raitzjm/SkidSteer_PCB/SkidSteer_PCB.jpg

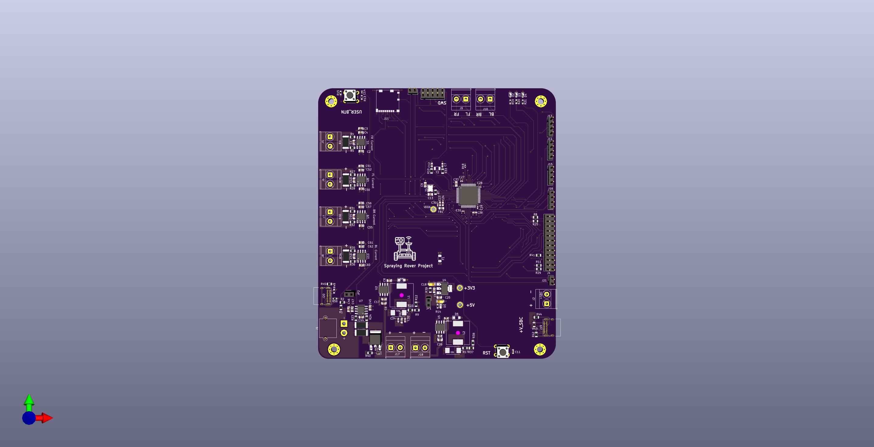
SkidSteer_PCB.jpg
