raitzjm/SkidSteer_PCB/README.md

# SkidSteer_PCB
PCB for skid steer spraying rover project for KSU Precision Ag Lab
