raitzjm/SkidSteer_PCB/Documentation/Capture.PNG

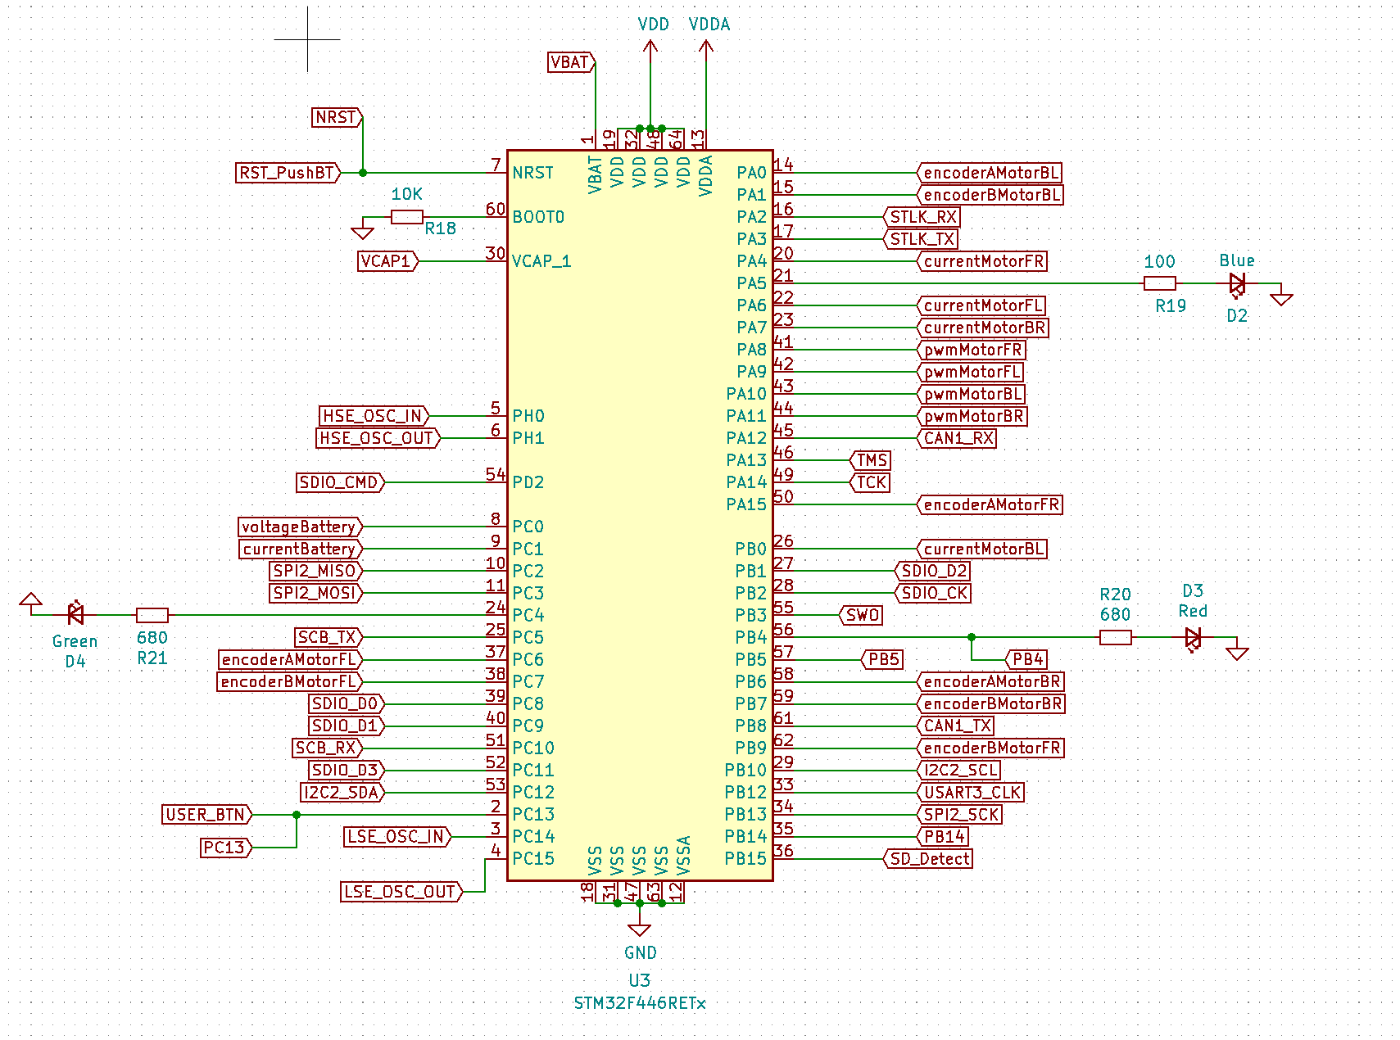
Documentation/Capture.PNG
