raitzjm/SkidSteer_PCB/SkidSteer_PCB.kicad_pcb

## KiCad design SkidSteer_PCB.kicad_pcb (2021-12-23)

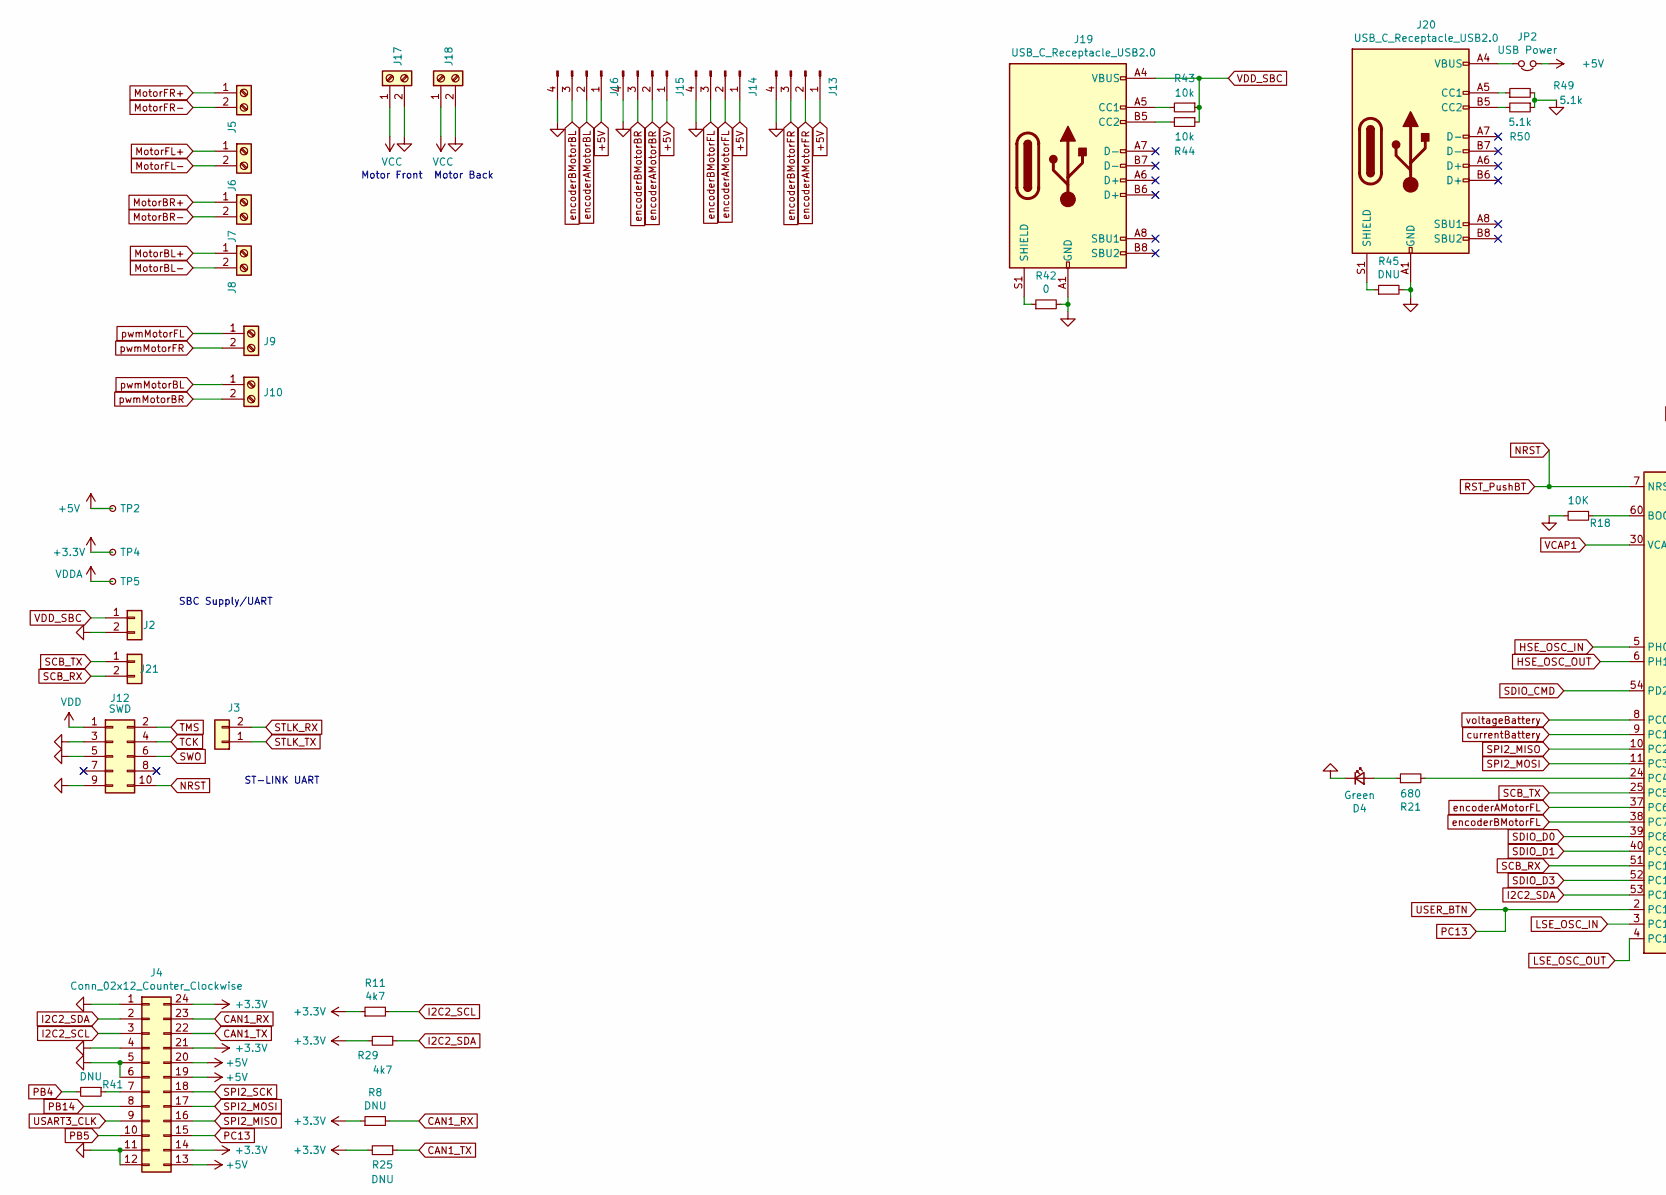
[picture p5: schematic SkidSteer_PCB.sch, part in row 1, column 1]

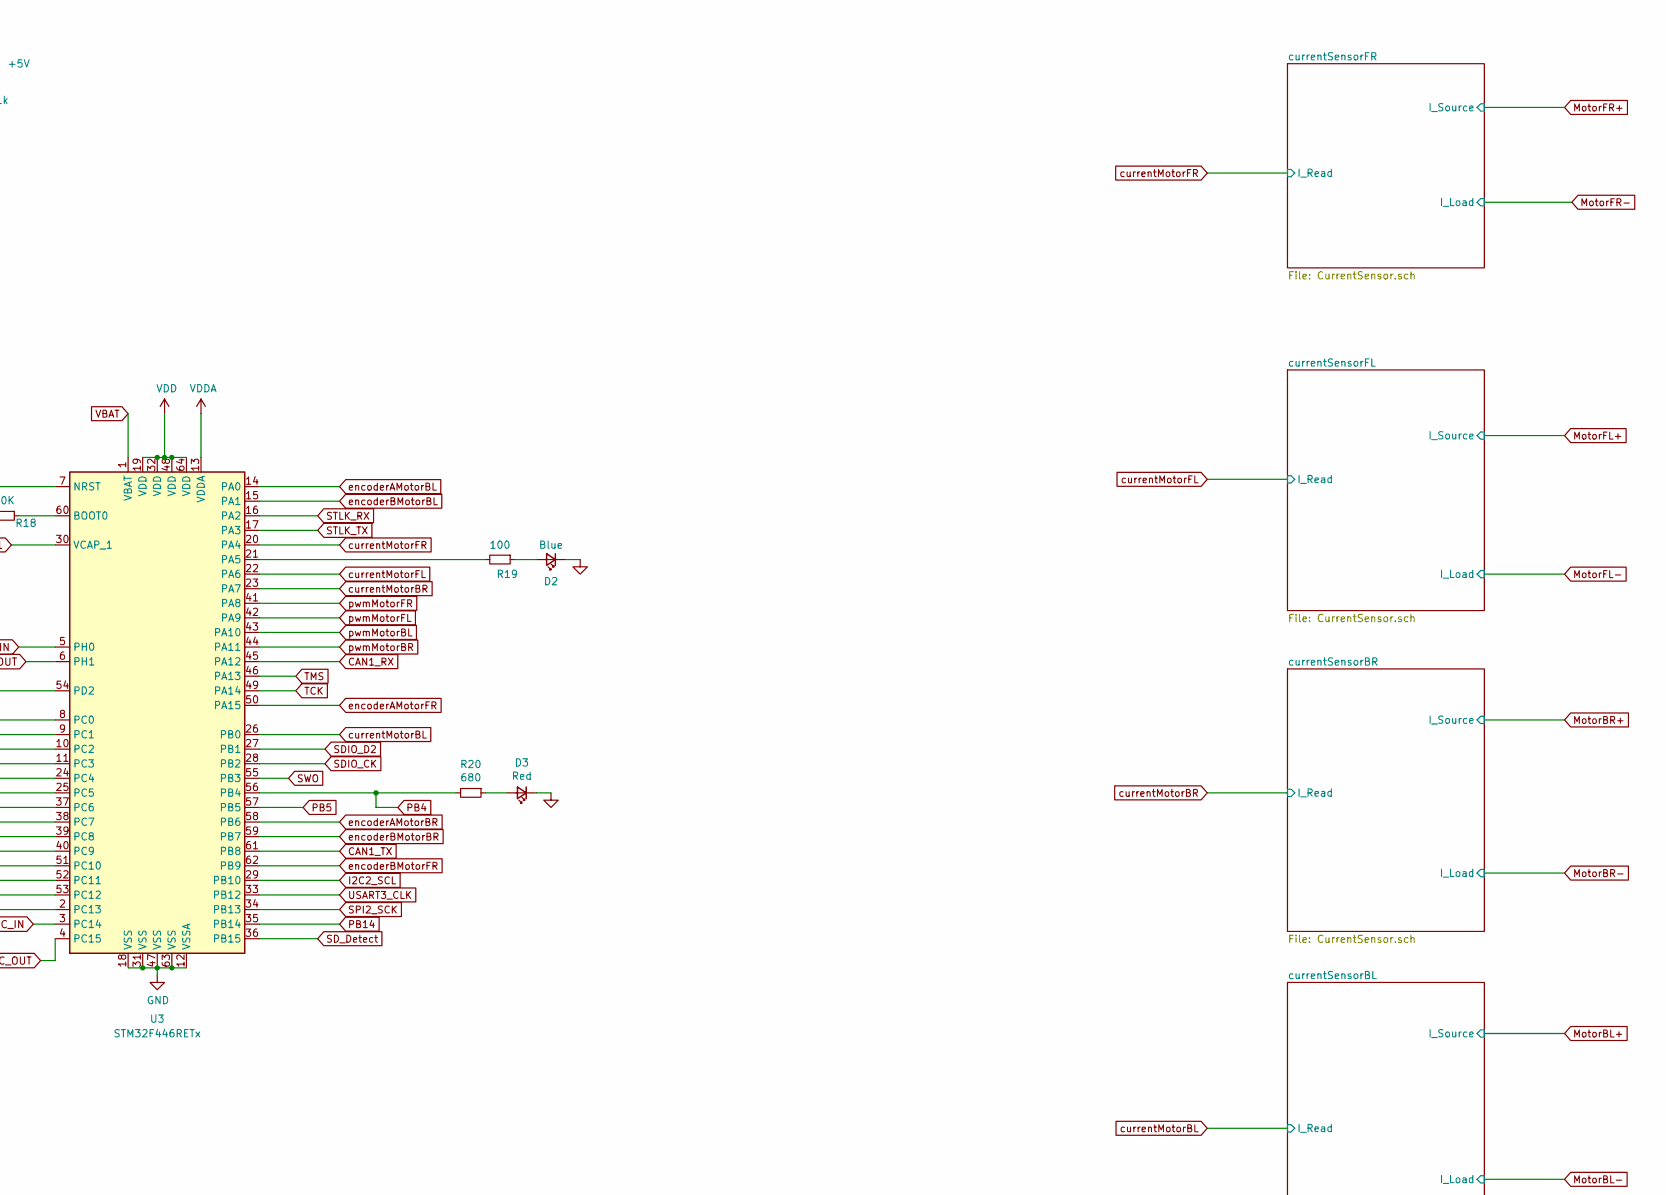
[picture p6: schematic SkidSteer_PCB.sch, part in row 1, column 2]

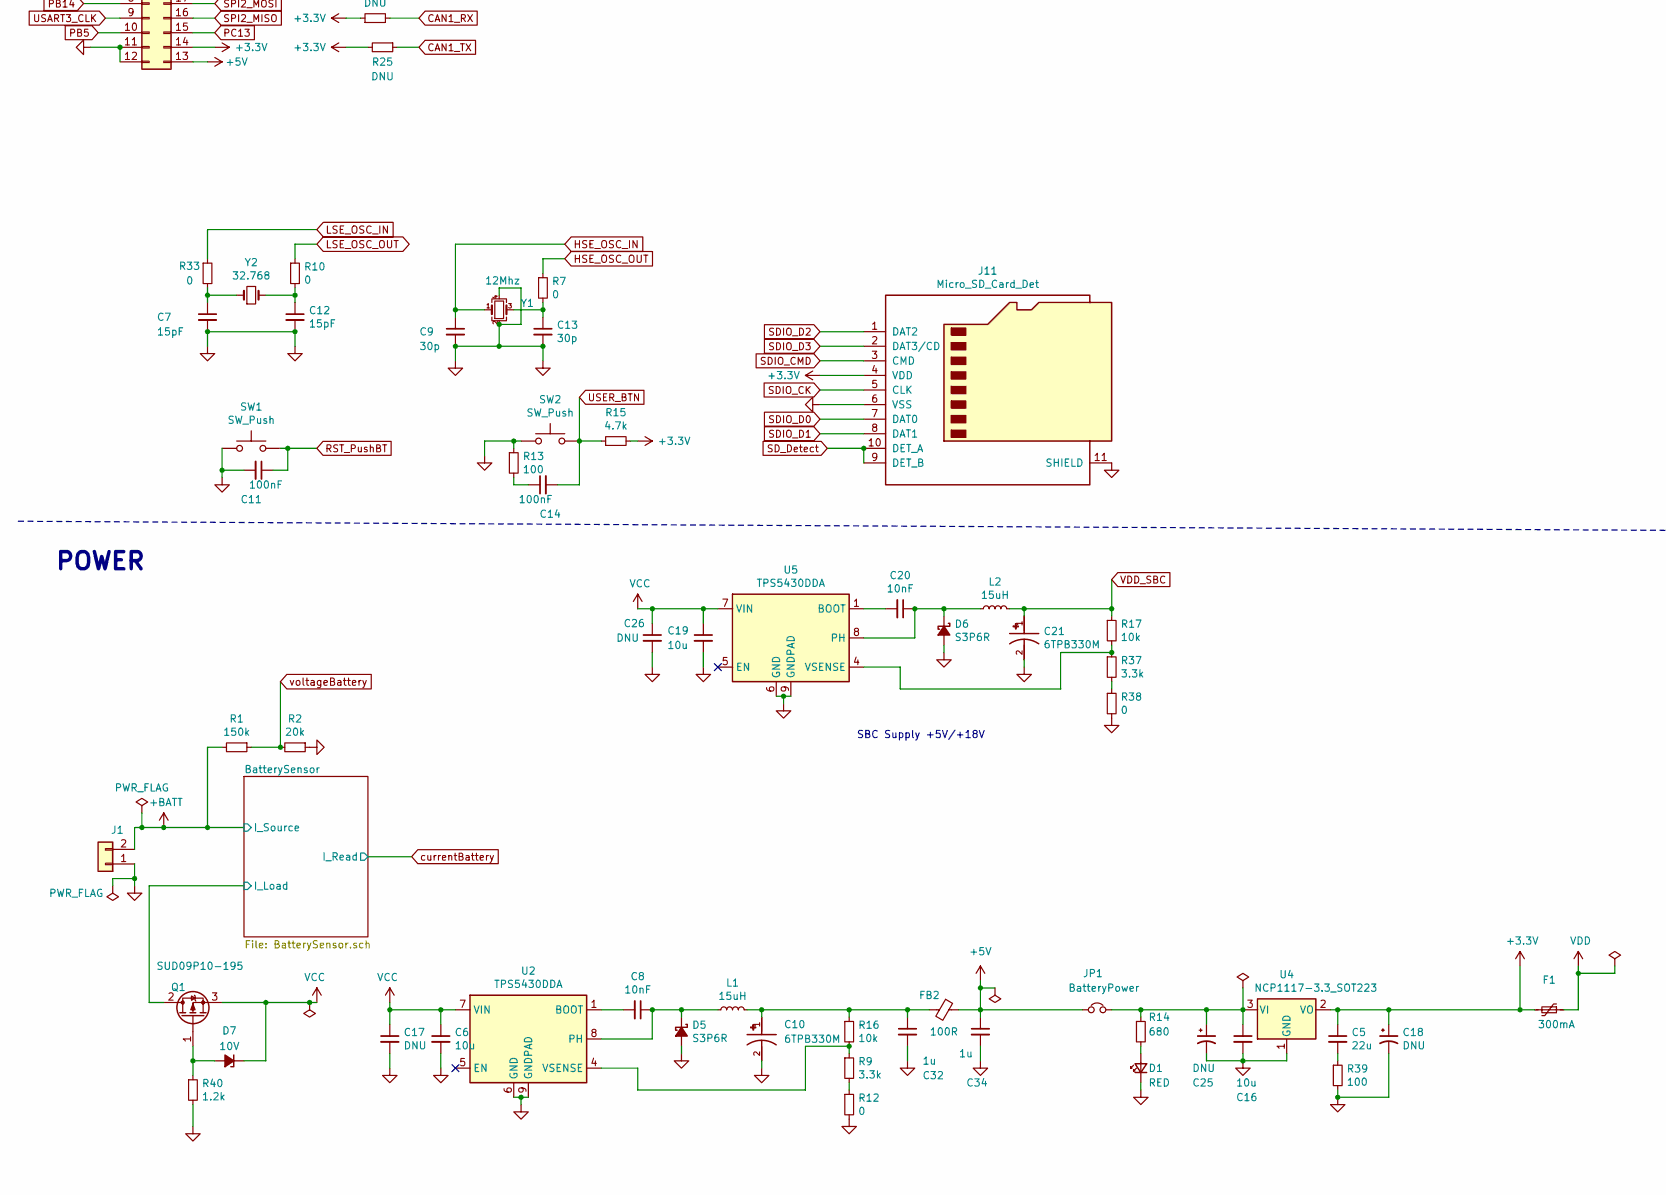
[picture p7: schematic SkidSteer_PCB.sch, part in row 2, column 1]

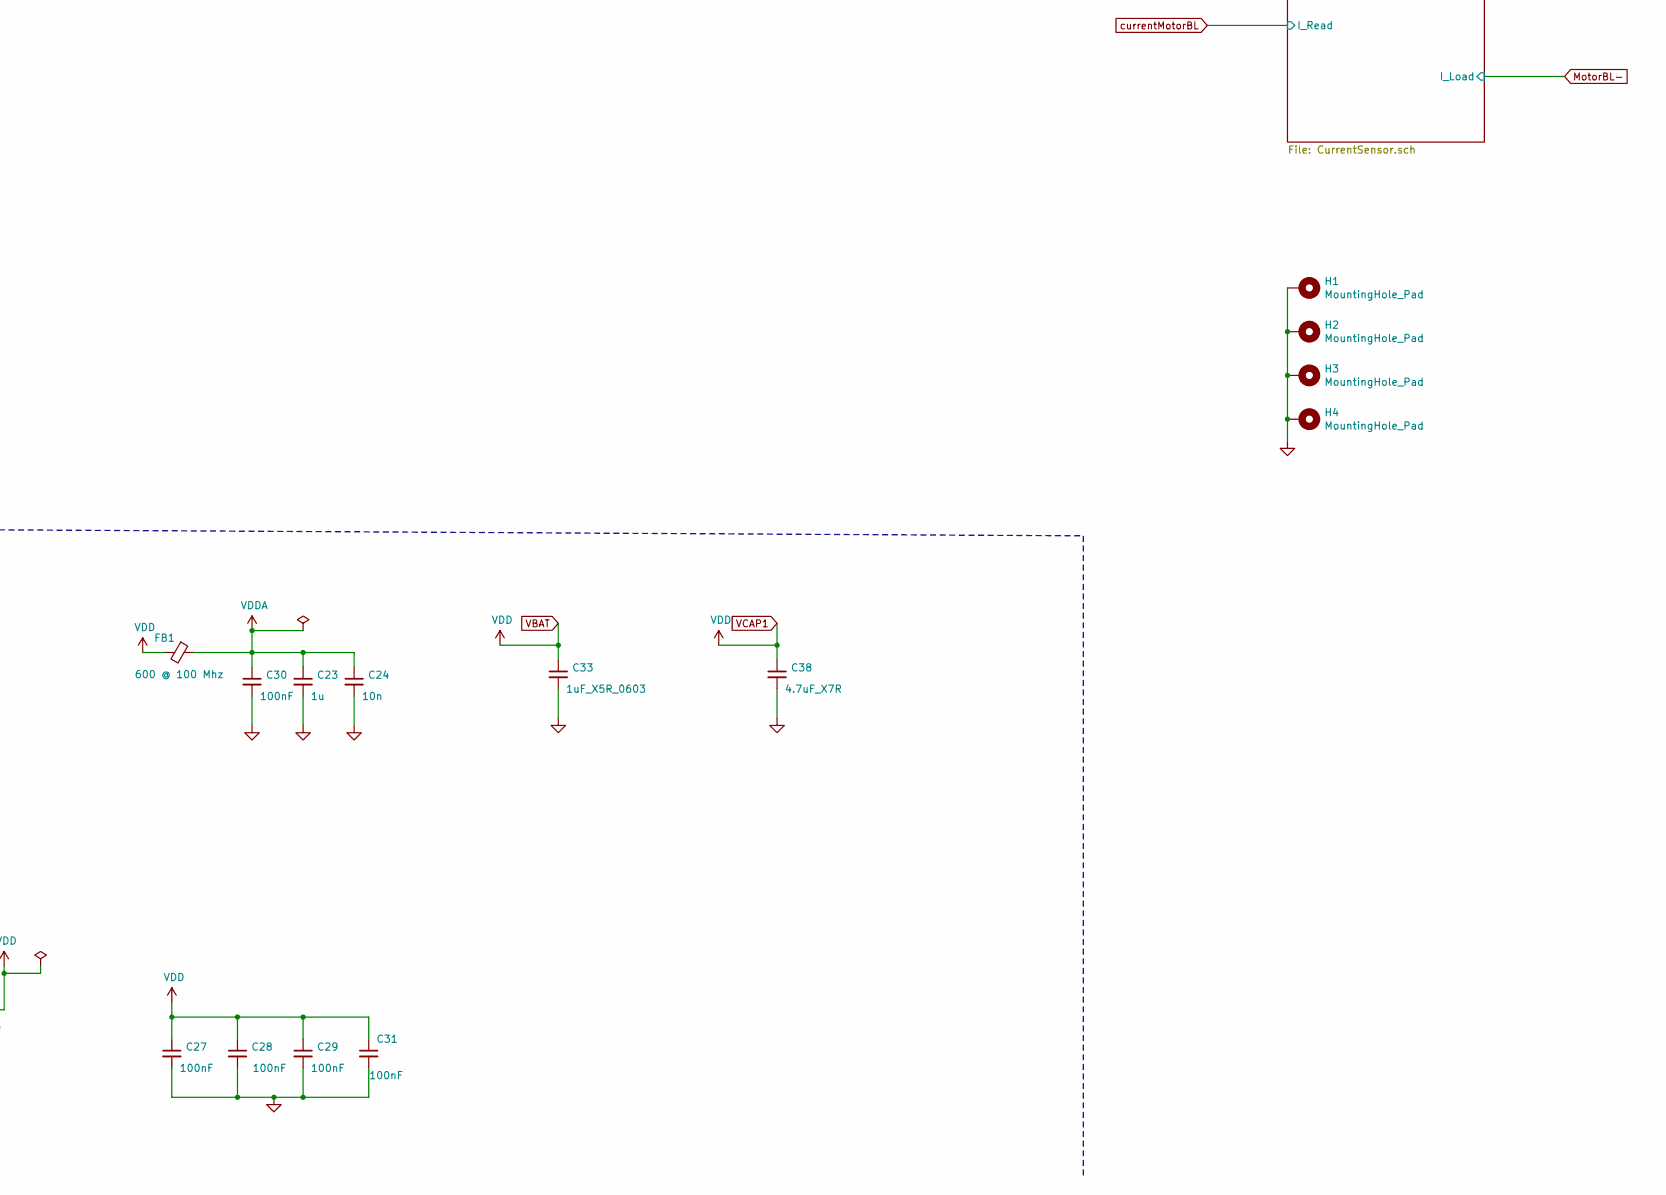
[picture p8: schematic SkidSteer_PCB.sch, part in row 2, column 2]

Parts:
C5: 22u; C_0805_2012Metric; LCSC Part # C45783
C6, C16, C19: 10u; C_0805_2012Metric; LCSC Part # C15850
C7, C12: 15pF; C_0603_1608Metric; LCSC Part # C1644
C8, C20: 10nF; C_0805_2012Metric; LCSC Part # C1710
C9, C13: 30p; C_0805_2012Metric; LCSC Part # C51207
C10, C21: 6TPB330M; CAP_6TPB330M; PARTREV 30-Nov-20; LCSC Part # C179787
C11: 100nF; C_0603_1608Metric; LCSC Part # C14663
C14, C27, C28, C29, C30, C31: 100nF; C_0402_1005Metric; LCSC Part # C1525
C17, C26: DNU; C_0805_2012Metric
C18, C25: DNU; CP_EIA-3216-18_Kemet-A
C23, C32, C34: 1u; C_0603_1608Metric; LCSC Part # C15849
C24: 10n; C_0603_1608Metric; LCSC Part # C57112
C33: 1uF_X5R_0603; C_0603_1608Metric; LCSC Part # C15849
C38: 4.7uF_X7R; C_0603_1608Metric; LCSC Part # C23630
D1: RED; LED_0603_1608Metric; LCSC Part # C84256
D2: Blue; LED_0603_1608Metric; LCSC Part # C72041
D3: Red; LED_0603_1608Metric; LCSC Part # C72038
D4: Green; LED_0603_1608Metric; LCSC Part # C72043
D5, D6: S3P6R; D_SMF; LCSC Part # C179787
D7: 10V; D_SOD-323; LCSC Part # C39057
F1: 300mA; Fuse_1206_3216Metric; LCSC Part # C17901
FB1: 600 @ 100 Mhz; L_0805_2012Metric; LCSC Part # C1017
FB2: 100R; L_0805_2012Metric; LCSC Part # C1015
H1, H2, H3, H4: MountingHole_Pad; MountingHole_3.2mm_M3_Pad_Via
J1: Conn_01x02; AMASS_XT30PW-M_1x02_P2.50mm_Horizontal
J2: Conn_01x02; TerminalBlock_Phoenix_MKDS-3-2-5.08_1x02_P5.08mm_Horizontal
J3, J21: Conn_01x02; PinHeader_1x02_P2.54mm_Vertical
J4: Conn_02x12_Counter_Clockwise; PinHeader_2x12_P2.54mm_Vertical
J5, J6, J7, J8, J9, J10, J17, J18: Screw_Terminal_01x02; TerminalBlock_Phoenix_MKDS-3-2-5.08_1x02_P5.08mm_Horizontal
J11: Micro_SD_Card_Det; microSD_HC_Molex_104031-0811
J12: SWD; PinHeader_2x05_P2.54mm_Vertical
J13, J14, J15, J16: Conn_01x04_Male; PinHeader_1x04_P2.54mm_Vertical
J19, J20: USB_C_Receptacle_USB2.0; USB_C_Receptacle_GCT_USB4085
JP1: BatteryPower; PinSocket_1x02_P2.54mm_Vertical
JP2: USB Power; PinSocket_1x02_P2.54mm_Vertical
L1, L2: 15uH; L_12x12mm_H8mm; LCSC Part # C167263
Q1: SUD09P10-195; TO-252-2; LCSC Part # C165222
R1: 150k; R_0805_2012Metric; LCSC Part # C17470
R2: 20k; R_0805_2012Metric; LCSC Part # C4328
R7, R10, R12, R33, R38, R42: 0; R_0805_2012Metric; LCSC Part # C17408
R8, R25, R41, R45: DNU; R_0805_2012Metric
R9, R37: 3.3k; R_0805_2012Metric; LCSC Part # C26010
R11, R29: 4k7; R_0805_2012Metric; LCSC Part # C17673
R13, R19: 100; R_0603_1608Metric; LCSC Part # C22775
R14, R20, R21: 680; R_0603_1608Metric; LCSC Part # C23228
R15: 4.7k; R_0603_1608Metric; LCSC Part # C23162
R16, R17, R43, R44: 10k; R_0805_2012Metric; LCSC Part # C17414
R18: 10K; R_0402_1005Metric; LCSC Part # C25744
R39: 100; R_0805_2012Metric; LCSC Part # C17408
R40: 1.2k; R_0805_2012Metric; LCSC Part # C17379
R49, R50: 5.1k; R_0603_1608Metric; LCSC Part # C23186
SW1, SW2: SW_Push; SW_PUSH_6mm
TP2: +5V; TestPoint_Plated_Hole_D2.0mm
TP4: +3V3; TestPoint_Plated_Hole_D2.0mm
TP5: VDDA; TestPoint_Plated_Hole_D2.0mm
U2, U5: TPS5430DDA; TI_SO-PowerPAD-8_ThermalVias; LCSC Part # C9864
U3: STM32F446RETx; LQFP-64_10x10mm_P0.5mm
U4: NCP1117-3.3_SOT223; SOT-223-3_TabPin2; LCSC Part # C6186
Y1: 12Mhz; Crystal_SMD_3225-4Pin_3.2x2.5mm; LCSC Part # 7V12000018
Y2: 32.768; Crystal_SMD_3215-2Pin_3.2x1.5mm; LCSC Part # C271654

Connections:
+3V3: C5.1, C18.1, F1.2, J4.14, J4.21, J4.24, J11.4 (VDD), R8.1, R11.1, R15.2, R25.2, R29.2, TP4.1, U4.2 (VO); also elsewhere on the board
+5V: C34.1, FB2.1, J4.13, J4.19, J4.20, J13.1, J14.1, J15.1, J16.1, JP1.1, JP2.1, TP2.1
CAN1_RX: J4.23, R8.2, U3.45 (PA12)
CAN1_TX: J4.22, R25.1, U3.61 (PB8)
GND: C6.2, C7.2, C9.2, C10.2, C11.2, C12.2, C13.2, C16.2, C17.2, C18.2, C19.2, C21.2, C23.2, C24.2, C25.2, C26.2, C27.2, C28.2, C29.2, C30.2, C31.2, C32.2, C33.2, C34.2, C38.2, D1.1 (K), D2.1 (K), D3.1 (K), D4.1 (K), D5.2 (A), D6.2 (A), H1.1, H2.1, H3.1, H4.1, J1.1, J2.2, J4.1, J4.4, J4.5, J4.6, J4.11, J4.12, J11.6 (VSS), J11.11 (SHIELD), J12.3, J12.5, J12.9, J13.4, J14.4, J15.4, J16.4, J17.2, J18.2, J19.A1 (GND), J19.A12 (GND), J19.B1 (GND), J19.B12 (GND), J20.A1 (GND), J20.A12 (GND), J20.B1 (GND), J20.B12 (GND), R2.1, R12.2, R13.1, R18.2, R38.2, R39.2, R40.2, R42.2, R45.2, R49.2, R50.1, SW1.1, SW2.2, U2.6 (GND), U2.9 (GNDPAD), U3.12 (VSSA), U3.18 (VSS), U3.31 (VSS), U3.47 (VSS), U3.63 (VSS), U4.1 (GND), U5.6 (GND), U5.9 (GNDPAD), Y1.2, Y1.4; also elsewhere on the board
HSE_OSC_IN: C9.1, U3.5 (PH0), Y1.1
HSE_OSC_OUT: R7.1, U3.6 (PH1)
I2C2_SCL: J4.3, R11.2, U3.29 (PB10)
I2C2_SDA: J4.2, R29.1, U3.53 (PC12)
LSE_OSC_IN: R33.1, U3.3 (PC14)
LSE_OSC_OUT: R10.1, U3.4 (PC15)
MotorBL+: J8.1; also elsewhere on the board
MotorBL-: J8.2; also elsewhere on the board
MotorBR+: J7.1; also elsewhere on the board
MotorBR-: J7.2; also elsewhere on the board
MotorFL+: J6.1; also elsewhere on the board
MotorFL-: J6.2; also elsewhere on the board
NRST: C11.1, J12.10, SW1.2, U3.7 (NRST)
unnamed: C5.2, R39.1
unnamed: C7.1, R33.2, Y2.1
unnamed: C8.1, D5.1 (K), L1.1, U2.8 (PH)
unnamed: C8.2, U2.1 (BOOT)
unnamed: C10.1, C32.1, FB2.2, L1.2, R16.1
unnamed: C12.1, R10.2, Y2.2
unnamed: C13.1, R7.2, Y1.3
unnamed: C14.1, R13.2
unnamed: C16.1, C25.1, JP1.2, R14.1, U4.3 (VI)
unnamed: C20.1, D6.1 (K), L2.1, U5.8 (PH)
unnamed: C20.2, U5.1 (BOOT)
unnamed: D1.2 (A), R14.2
unnamed: D2.2 (A), R19.1
unnamed: D3.2 (A), R20.1
unnamed: D4.2 (A), R21.1
unnamed: D7.2 (A), Q1.1 (G), R40.1
unnamed: J4.7, R41.1
unnamed: J19.A5 (CC1), R43.2
unnamed: J19.B5 (CC2), R44.2
unnamed: J19.S1 (SHIELD), R42.1
unnamed: J20.A4 (VBUS), J20.A9 (VBUS), J20.B4 (VBUS), J20.B9 (VBUS), JP2.2
unnamed: J20.A5 (CC1), R49.1
unnamed: J20.B5 (CC2), R50.2
unnamed: J20.S1 (SHIELD), R45.1
unnamed: R9.2, R12.1
unnamed: R9.1, R16.2, U2.4 (VSENSE)
unnamed: R17.2, R37.1, U5.4 (VSENSE)
unnamed: R18.1, U3.60 (BOOT0)
unnamed: R19.2, U3.21 (PA5)
unnamed: R21.2, U3.24 (PC4)
unnamed: R37.2, R38.1
PB4: R20.2, R41.2, U3.56 (PB4)
PB5: J4.10, U3.57 (PB5)
PB14: J4.8, U3.35 (PB14)
PC13: C14.2, J4.15, R15.1, SW2.1, U3.2 (PC13)
SCB_RX: J21.2, U3.51 (PC10)
SCB_TX: J21.1, U3.25 (PC5)
SDIO_CK: J11.5 (CLK), U3.28 (PB2)
SDIO_CMD: J11.3 (CMD), U3.54 (PD2)
SDIO_D0: J11.7 (DAT0), U3.39 (PC8)
SDIO_D1: J11.8 (DAT1), U3.40 (PC9)
SDIO_D2: J11.1 (DAT2), U3.27 (PB1)
SDIO_D3: J11.2 (DAT3/CD), U3.52 (PC11)
SD_Detect: J11.9 (DET_B), J11.10 (DET_A), U3.36 (PB15)
SPI2_MISO: J4.16, U3.10 (PC2)
SPI2_MOSI: J4.17, U3.11 (PC3)
SPI2_SCK: J4.18, U3.34 (PB13)
STLK_RX: J3.2, U3.16 (PA2)
STLK_TX: J3.1, U3.17 (PA3)
SWO: J12.6, U3.55 (PB3)
TCK: J12.4, U3.49 (PA14)
TMS: J12.2, U3.46 (PA13)
USART3_CLK: J4.9, U3.33 (PB12)
VBAT: C27.1, C28.1, C29.1, C31.1, C33.1, C38.1, F1.1, FB1.2, J12.1, U3.1 (VBAT), U3.19 (VDD), U3.30 (VCAP_1), U3.32 (VDD), U3.48 (VDD), U3.64 (VDD)
VCC: C6.1, C17.1, C19.1, C26.1, D7.1 (K), J17.1, J18.1, Q1.3 (S), U2.7 (VIN), U5.7 (VIN)
VDDA: C23.1, C24.1, C30.1, FB1.1, TP5.1, U3.13 (VDDA)
VDD_SBC: C21.1, J2.1, J19.A4 (VBUS), J19.A9 (VBUS), J19.B4 (VBUS), J19.B9 (VBUS), L2.2, R17.1, R43.1, R44.1
currentBattery: U3.9 (PC1); also elsewhere on the board
currentMotorBL: U3.26 (PB0); also elsewhere on the board
currentMotorBR: U3.23 (PA7); also elsewhere on the board
currentMotorFL: U3.22 (PA6); also elsewhere on the board
currentMotorFR: U3.20 (PA4); also elsewhere on the board
encoderAMotorBL: J16.2, U3.14 (PA0)
encoderAMotorBR: J15.2, U3.58 (PB6)
encoderAMotorFL: J14.2, U3.37 (PC6)
encoderAMotorFR: J13.2, U3.50 (PA15)
encoderBMotorBL: J16.3, U3.15 (PA1)
encoderBMotorBR: J15.3, U3.59 (PB7)
encoderBMotorFL: J14.3, U3.38 (PC7)
encoderBMotorFR: J13.3, U3.62 (PB9)
pwmMotorBL: J10.1, U3.43 (PA10)
pwmMotorBR: J10.2, U3.44 (PA11)
pwmMotorFL: J9.1, U3.42 (PA9)
pwmMotorFR: J9.2, U3.41 (PA8)
voltageBattery: R1.1, R2.2, U3.8 (PC0)

Notes on the sheet:
POWER
ST-LINK UART
SBC Supply/UART
Motor Front
Motor Back
SBC Supply +5V/+18V

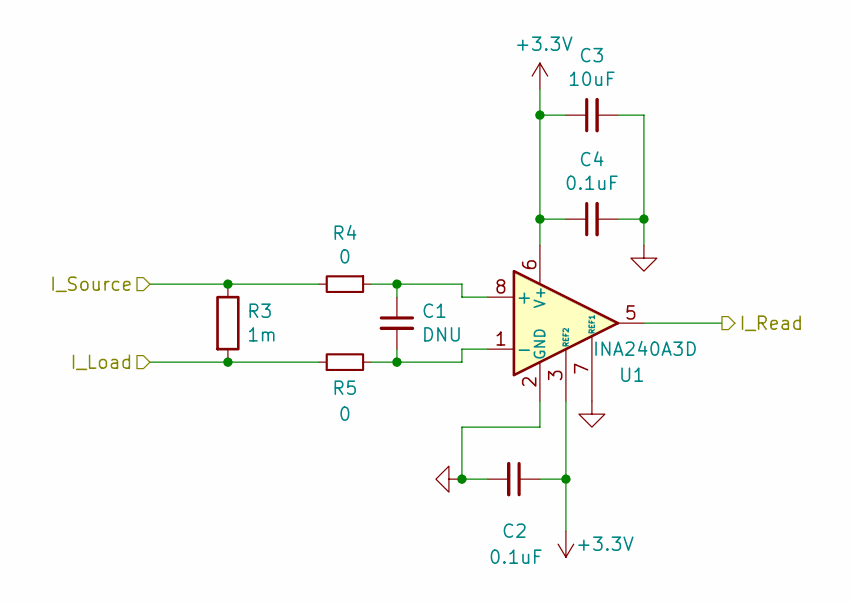
[picture p9: schematic CurrentSensor.sch]

Parts:
C1: DNU; C_0805_2012Metric
C2, C4: 0.1uF; C_0805_2012Metric; LCSC Part # C49678
C3: 10uF; C_0805_2012Metric; LCSC Part # C15850
R3: 1m; R_2512_6332Metric; LCSC Part # C323764
R4, R5: 0; R_0805_2012Metric; LCSC Part # C17408
U1: INA240A3D; SOIC-8_3.9x4.9mm_P1.27mm

Connections:
+3V3: C2.1, C3.1, C4.1, U1.3 (REF2), U1.6 (V+); also elsewhere on the board
GND: C2.2, C3.2, C4.2, U1.2 (GND), U1.4 (GND), U1.7 (REF1); also elsewhere on the board
unnamed: C1.1, R4.1, U1.8 (+)
unnamed: C1.2, R5.2, U1.1 (-)
currentMotorFR: U1.5; also elsewhere on the board

Parts of its further copies:
C44, C49, C54, C59: DNU; C_0805_2012Metric
C45, C47, C50, C52, C55, C57, C60, C62: 0.1uF; C_0805_2012Metric; LCSC Part # C49678
C46, C51, C56, C61: 10uF; C_0805_2012Metric; LCSC Part # C15850
R22, R26, R30, R34: 1m; R_2512_6332Metric; LCSC Part # C323764
R23, R24, R27, R28, R31, R32, R35, R36: 0; R_0805_2012Metric; LCSC Part # C17408
U7, U8, U9, U10: INA240A3D; SOIC-8_3.9x4.9mm_P1.27mm

Connections of its further copies:
+3V3: C45.1, C46.1, C47.1, C50.1, C51.1, C52.1, C55.1, C56.1, C57.1, C60.1, C61.1, C62.1, U7.3 (REF2), U7.6 (V+), U8.3 (REF2), U8.6 (V+), U9.3 (REF2), U9.6 (V+), U10.3 (REF2), U10.6 (V+); also elsewhere on the board
GND: C45.2, C46.2, C47.2, C50.2, C51.2, C52.2, C55.2, C56.2, C57.2, C60.2, C61.2, C62.2, U7.2 (GND), U7.4 (GND), U7.7 (REF1), U8.2 (GND), U8.4 (GND), U8.7 (REF1), U9.2 (GND), U9.4 (GND), U9.7 (REF1), U10.2 (GND), U10.4 (GND), U10.7 (REF1); also elsewhere on the board
MotorBL+: R34.1, R35.2; also elsewhere on the board
MotorBL-: R34.2, R36.1; also elsewhere on the board
MotorBR+: R30.1, R31.2; also elsewhere on the board
MotorBR-: R30.2, R32.1; also elsewhere on the board
MotorFL+: R26.1, R27.2; also elsewhere on the board
MotorFL-: R26.2, R28.1; also elsewhere on the board
unnamed: C44.1, R23.1, U7.8 (+)
unnamed: C44.2, R24.2, U7.1 (-)
unnamed: C49.1, R27.1, U8.8 (+)
unnamed: C49.2, R28.2, U8.1 (-)
unnamed: C54.1, R31.1, U9.8 (+)
unnamed: C54.2, R32.2, U9.1 (-)
unnamed: C59.1, R35.1, U10.8 (+)
unnamed: C59.2, R36.2, U10.1 (-)
currentBattery: U7.5; also elsewhere on the board
currentMotorBL: U10.5; also elsewhere on the board
currentMotorBR: U9.5; also elsewhere on the board
currentMotorFL: U8.5; also elsewhere on the board

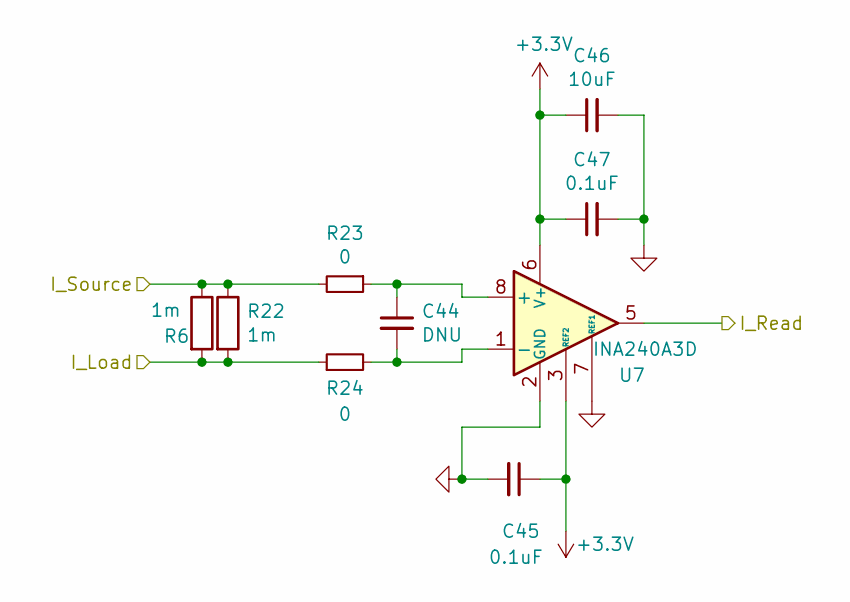
[picture p10: schematic BatterySensor.sch]

Parts:
C1: DNU; C_0805_2012Metric
C2, C4: 0.1uF; C_0805_2012Metric; LCSC Part # C49678
C3: 10uF; C_0805_2012Metric; LCSC Part # C15850
R3, R6: 1m; R_2512_6332Metric; LCSC Part # C323764
R4, R5: 0; R_0805_2012Metric; LCSC Part # C17408
U1: INA240A3D; SOIC-8_3.9x4.9mm_P1.27mm

Connections:
+3V3: C2.1, C3.1, C4.1, U1.3 (REF2), U1.6 (V+); also elsewhere on the board
GND: C2.2, C3.2, C4.2, U1.2 (GND), U1.4 (GND), U1.7 (REF1); also elsewhere on the board
unnamed: C1.1, R4.1, U1.8 (+)
unnamed: C1.2, R5.2, U1.1 (-)
currentMotorFR: U1.5; also elsewhere on the board

Parts of its further copies:
C44, C49, C54, C59: DNU; C_0805_2012Metric
C45, C47, C50, C52, C55, C57, C60, C62: 0.1uF; C_0805_2012Metric; LCSC Part # C49678
C46, C51, C56, C61: 10uF; C_0805_2012Metric; LCSC Part # C15850
R22, R26, R30, R34: 1m; R_2512_6332Metric; LCSC Part # C323764
R23, R24, R27, R28, R31, R32, R35, R36: 0; R_0805_2012Metric; LCSC Part # C17408
U7, U8, U9, U10: INA240A3D; SOIC-8_3.9x4.9mm_P1.27mm

Connections of its further copies:
+3V3: C45.1, C46.1, C47.1, C50.1, C51.1, C52.1, C55.1, C56.1, C57.1, C60.1, C61.1, C62.1, U7.3 (REF2), U7.6 (V+), U8.3 (REF2), U8.6 (V+), U9.3 (REF2), U9.6 (V+), U10.3 (REF2), U10.6 (V+); also elsewhere on the board
GND: C45.2, C46.2, C47.2, C50.2, C51.2, C52.2, C55.2, C56.2, C57.2, C60.2, C61.2, C62.2, U7.2 (GND), U7.4 (GND), U7.7 (REF1), U8.2 (GND), U8.4 (GND), U8.7 (REF1), U9.2 (GND), U9.4 (GND), U9.7 (REF1), U10.2 (GND), U10.4 (GND), U10.7 (REF1); also elsewhere on the board
MotorBL+: R34.1, R35.2; also elsewhere on the board
MotorBL-: R34.2, R36.1; also elsewhere on the board
MotorBR+: R30.1, R31.2; also elsewhere on the board
MotorBR-: R30.2, R32.1; also elsewhere on the board
MotorFL+: R26.1, R27.2; also elsewhere on the board
MotorFL-: R26.2, R28.1; also elsewhere on the board
unnamed: C44.1, R23.1, U7.8 (+)
unnamed: C44.2, R24.2, U7.1 (-)
unnamed: C49.1, R27.1, U8.8 (+)
unnamed: C49.2, R28.2, U8.1 (-)
unnamed: C54.1, R31.1, U9.8 (+)
unnamed: C54.2, R32.2, U9.1 (-)
unnamed: C59.1, R35.1, U10.8 (+)
unnamed: C59.2, R36.2, U10.1 (-)
currentBattery: U7.5; also elsewhere on the board
currentMotorBL: U10.5; also elsewhere on the board
currentMotorBR: U9.5; also elsewhere on the board
currentMotorFL: U8.5; also elsewhere on the board

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
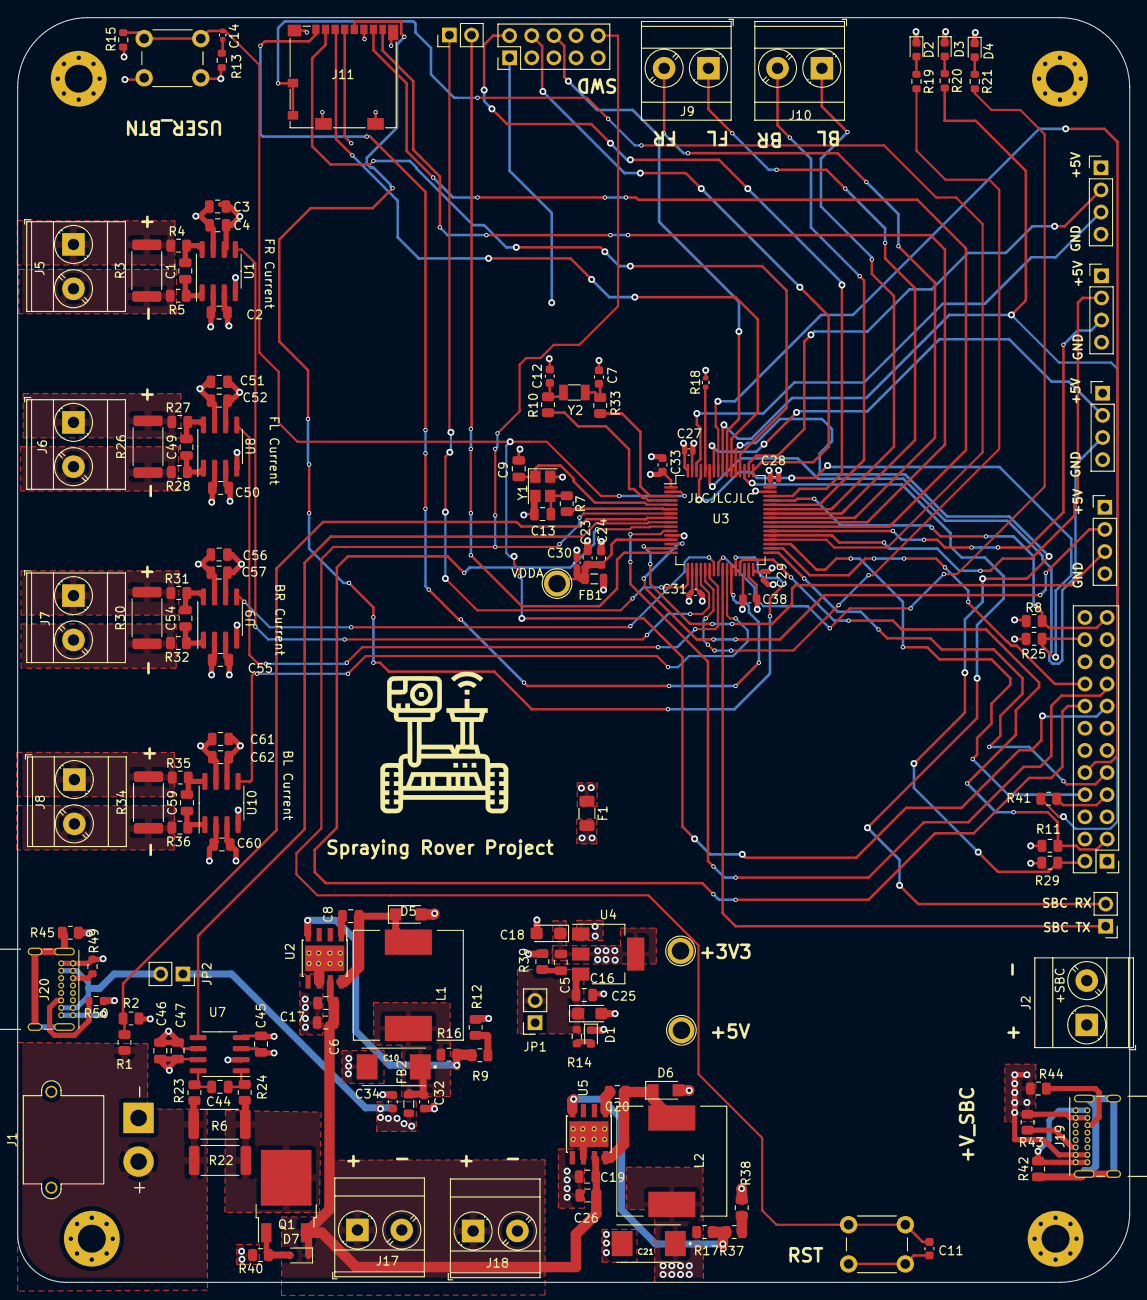
[picture p11: board SkidSteer_PCB.kicad_pcb from above]

Board: 4 copper layers, 127.5 x 145.0 mm, 152 parts (0 on the bottom side), 107 nets.
